T-D-Rabbit/ProjectCarRocketBoy/docs/pcb_mcu_zone.png

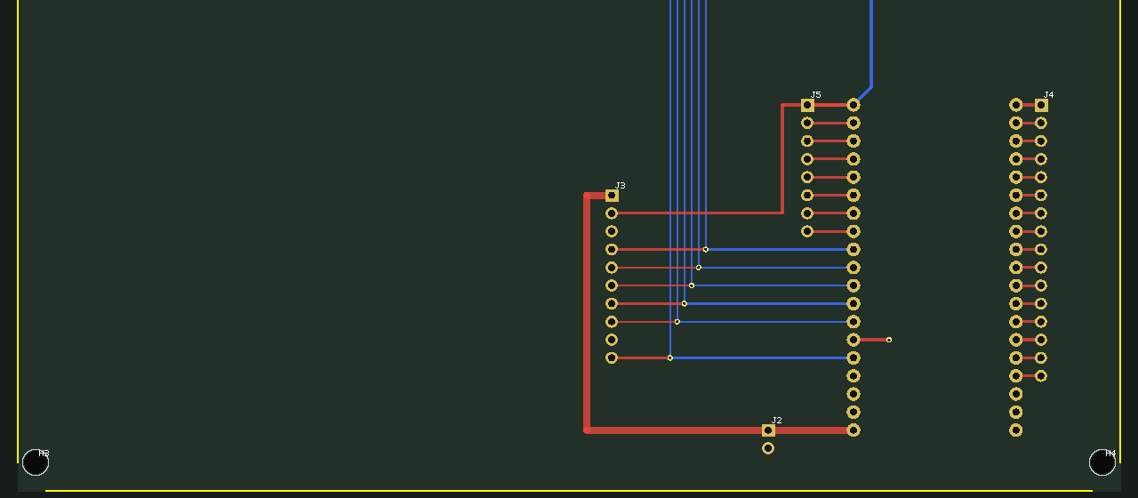
docs/pcb_mcu_zone.png
