T-D-Rabbit/ProjectCarRocketBoy/docs/pcb_power_channel.png

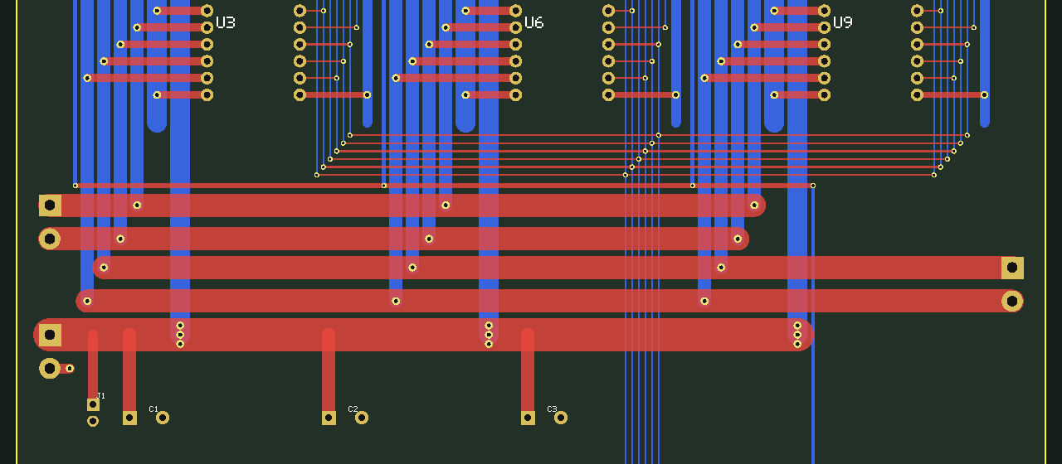
docs/pcb_power_channel.png
