T-D-Rabbit/ProjectCarRocketBoy/model3d/out/preview_front.png

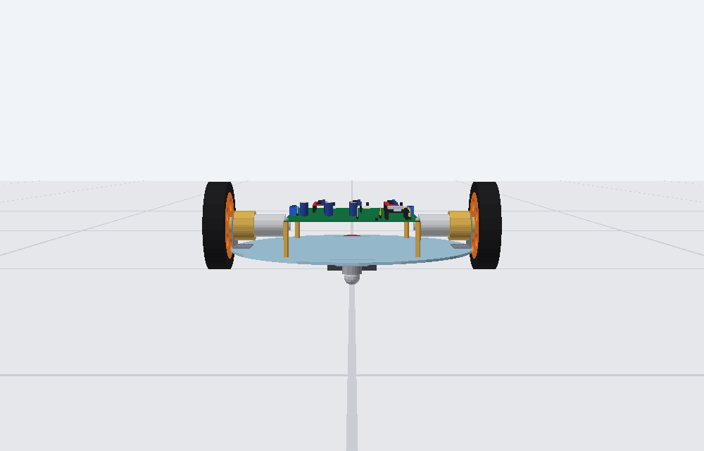
model3d/out/preview_front.png
