T-D-Rabbit/ProjectCarRocketBoy/model3d/out/preview_side.png

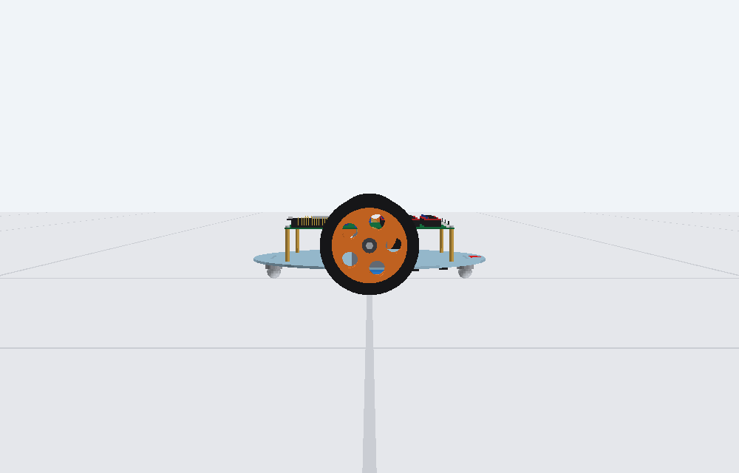
model3d/out/preview_side.png
