T-D-Rabbit/ProjectCarRocketBoy/model3d/out/preview_top.png

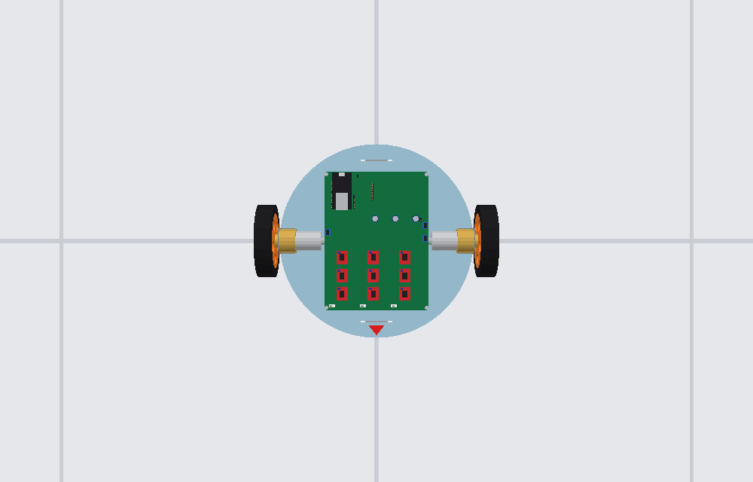
model3d/out/preview_top.png
