T-D-Rabbit/ProjectCarRocketBoy/model3d/out/preview_under.png

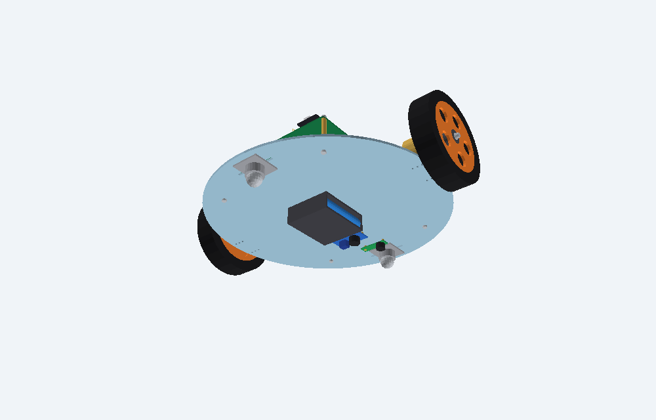
model3d/out/preview_under.png
