T-D-Rabbit/ProjectCarRocketBoy/model3d/out/rocketboy_assembly.stl

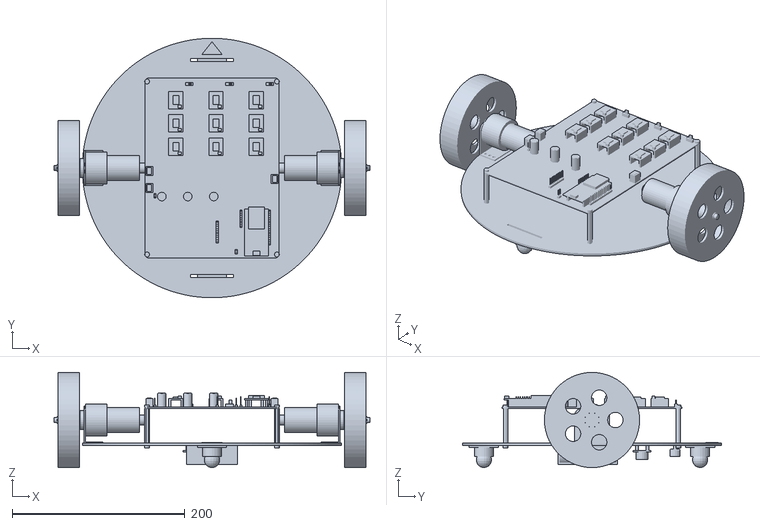
[picture p10: CAD file, 2026-10-31]
model3d/out/rocketboy_assembly.stl
365.4 x 300.0 x 110.0
