T-D-Rabbit/ProjectCarRocketBoy/Chassis file.step

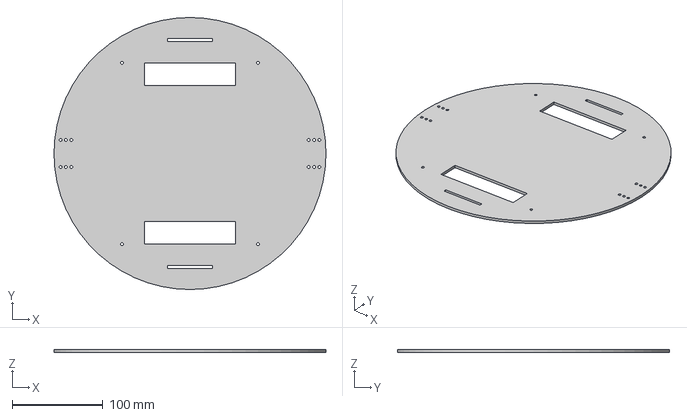
[picture p11: CAD file, 2026-10-31]
Chassis file.step
300.0 x 300.0 x 3.00 mm
