T-D-Rabbit/ProjectCarRocketBoy/model3d/out/rocketboy_body.stl

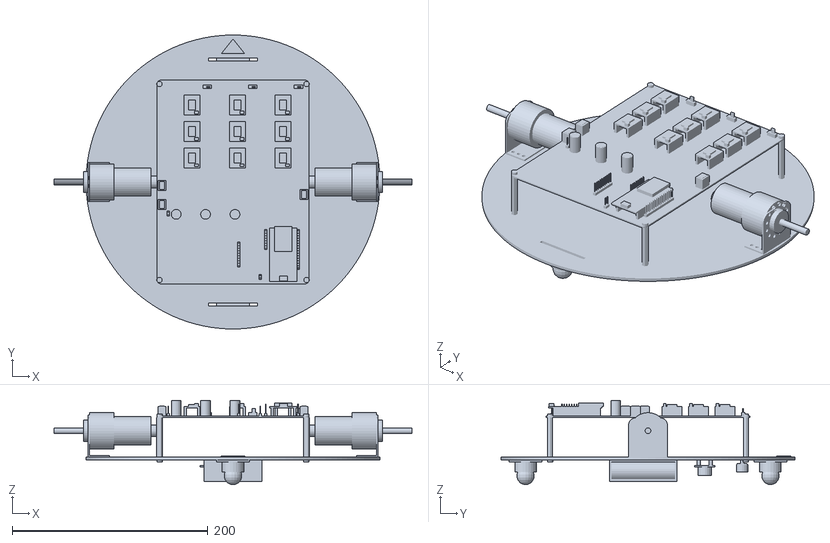
[picture p12: CAD file, 2026-10-31]
model3d/out/rocketboy_body.stl
365.4 x 300.0 x 86.1
