T-D-Rabbit/ProjectCarRocketBoy/model3d/out/rocketboy_wheel_left.stl

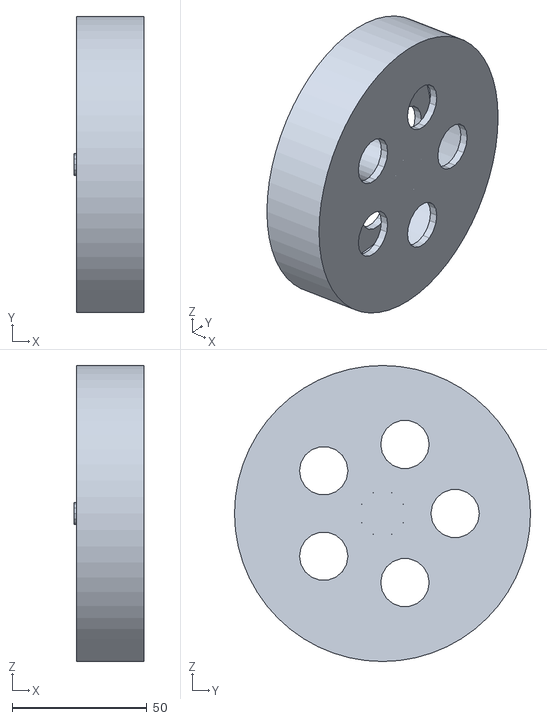
[picture p13: CAD file, 2026-10-31]
model3d/out/rocketboy_wheel_left.stl
26.0 x 110.0 x 110.0
