T-D-Rabbit/ProjectCarRocketBoy/(list of files, cad)

Other CAD files:
model3d/out/rocketboy.obj
model3d/out/rocketboy_wheel_right.stl
