T-D-Rabbit/ProjectCarRocketBoy/simulation/results/S1_launch_1group.csv

t | x | y | th | v | wz | il | ir | vbat | soc | ibat
0.0005 | 0 | 0 | 0 | 0 | 0 | 6.83726 | 6.88587 | 10.8786 | 0.899999 | 14.0731
0.01 | 0.000239984 | 6.3263e-10 | 4.48349e-06 | 0.0525382 | 0.000780485 | 5.82054 | 5.85912 | 11.085 | 0.899988 | 12.0297
0.02 | 0.00110173 | 9.05709e-09 | 1.38014e-05 | 0.116773 | 0.0010174 | 5.54294 | 5.57682 | 11.1415 | 0.899976 | 11.4698
0.03 | 0.0026089 | 3.87064e-08 | 2.4355e-05 | 0.181445 | 0.00107776 | 5.28424 | 5.31386 | 11.1942 | 0.899965 | 10.9481
0.04 | 0.00476314 | 1.04044e-07 | 3.52446e-05 | 0.246171 | 0.00109606 | 5.04268 | 5.06847 | 11.2433 | 0.899954 | 10.4612
0.05 | 0.00756472 | 2.19544e-07 | 4.62476e-05 | 0.310908 | 0.00110336 | 4.81708 | 4.83943 | 11.2892 | 0.899944 | 10.0065
0.06 | 0.0110137 | 3.9966e-07 | 5.73096e-05 | 0.375647 | 0.00110895 | 4.60638 | 4.62563 | 11.3321 | 0.899935 | 9.58201
0.07 | 0.01511 | 6.58933e-07 | 6.84455e-05 | 0.440385 | 0.00111919 | 4.40959 | 4.42607 | 11.3721 | 0.899925 | 9.18566
0.08 | 0.0198537 | 1.01229e-06 | 7.97607e-05 | 0.505116 | 0.00114764 | 4.22577 | 4.23979 | 11.4094 | 0.899916 | 8.81556
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
