T-D-Rabbit/ProjectCarRocketBoy/simulation/results/S5_route_30hz.csv

t | x | y | th | phil | phir | v | wz | il | ir | vbat | ul | ur | seg
0.005 | 9.32264e-07 | 1.76697e-14 | 3.16603e-08 | 4.45184e-05 | 4.48415e-05 | 0.000436205 | 1.37026e-05 | 0.0993634 | 0.10005 | 12.2445 | 0.015 | 0.015 | side 1
0.035 | 0.000173748 | 4.05817e-10 | 4.48549e-06 | 0.00397152 | 0.00400148 | 0.0132362 | 0.000332022 | 0.653834 | 0.658066 | 12.1321 | 0.105 | 0.105 | side 1
0.07 | 0.0011294 | 1.66401e-08 | 2.94938e-05 | 0.0232924 | 0.0234808 | 0.0440165 | 0.00120297 | 1.23206 | 1.23934 | 12.015 | 0.21 | 0.21 | side 1
0.1 | 0.00307709 | 1.28119e-07 | 8.42698e-05 | 0.0613378 | 0.0618679 | 0.0881543 | 0.00248894 | 1.65462 | 1.66333 | 11.9295 | 0.3 | 0.3 | side 1
0.135 | 0.00740478 | 7.5533e-07 | 0.000202441 | 0.144259 | 0.145518 | 0.161796 | 0.00426297 | 2.06138 | 2.07083 | 11.8472 | 0.405 | 0.405 | side 1
0.17 | 0.0146786 | 2.90995e-06 | 0.000384432 | 0.28184 | 0.284215 | 0.255525 | 0.00611258 | 2.39132 | 2.40089 | 11.7805 | 0.51 | 0.51 | side 1
0.2 | 0.023742 | 7.3628e-06 | 0.000591821 | 0.451951 | 0.455593 | 0.348972 | 0.00768019 | 2.62454 | 2.63387 | 11.7334 | 0.6 | 0.6 | side 1
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
