T-D-Rabbit/ProjectCarRocketBoy/simulation/results/S1_launch.png

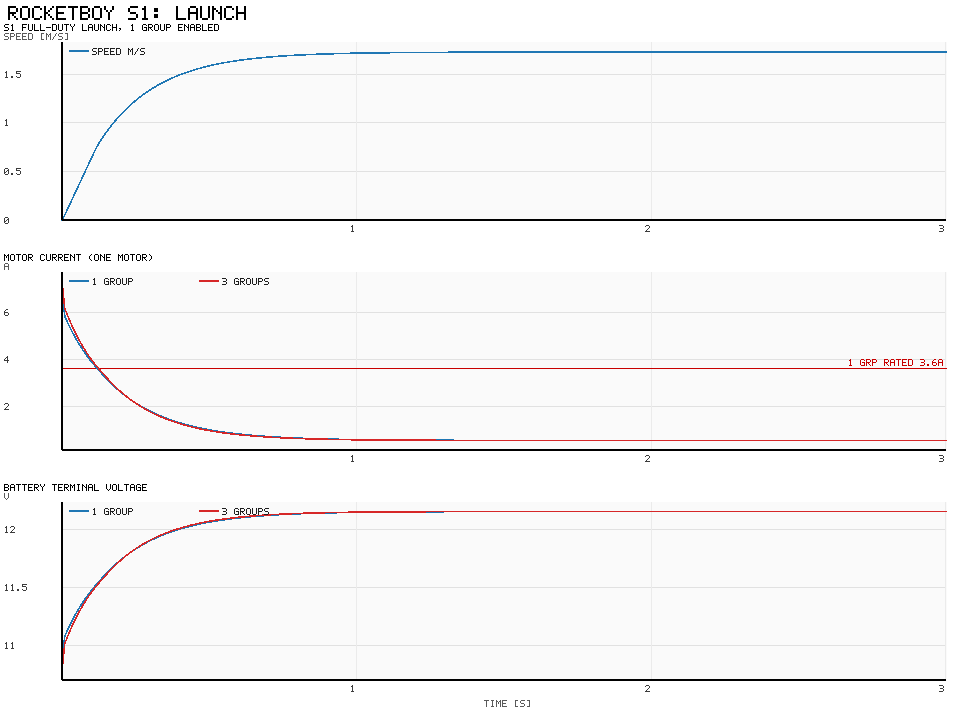
simulation/results/S1_launch.png
