T-D-Rabbit/ProjectCarRocketBoy/simulation/results/S5_route.png

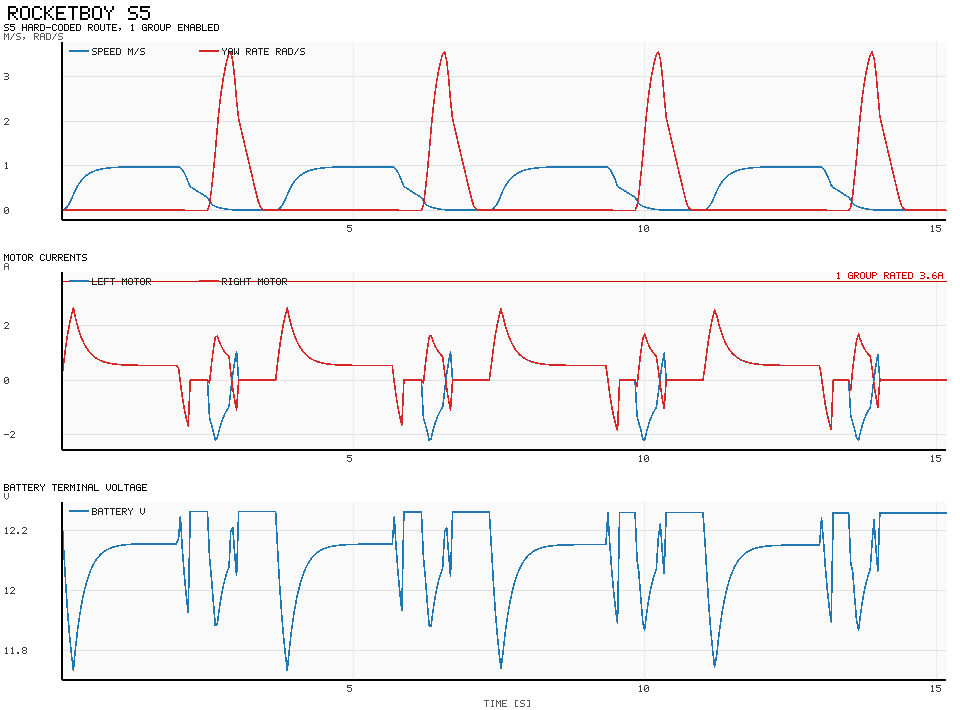
simulation/results/S5_route.png
