T-D-Rabbit/ProjectCarRocketBoy/simulation/results/S5_route_topview.png

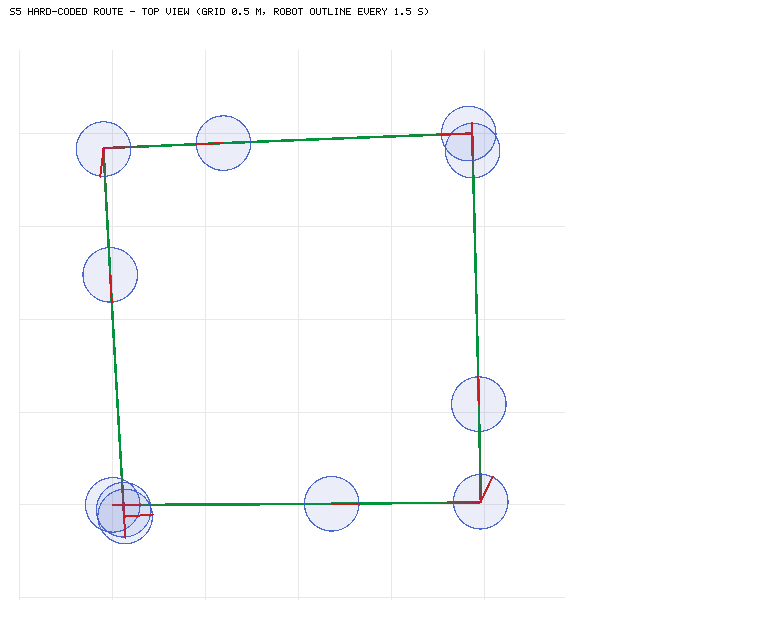
simulation/results/S5_route_topview.png
