T-D-Rabbit/ProjectCarRocketBoy/Johnson Motor.pdf

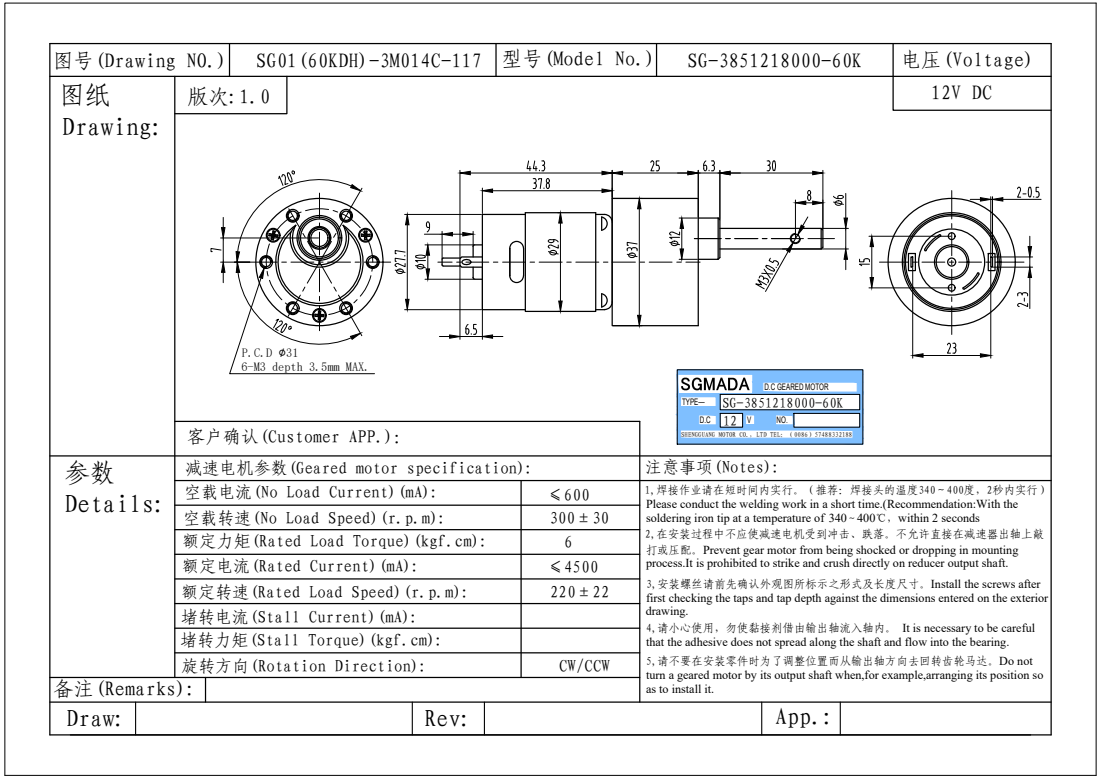
[picture p17: page 1]
图号(Drawing NO.); 型号(Model No.); 电压(Voltage) Draw:; Rev:; App.: 版次:1.0 客户确认(Customer APP.)：; 12V DC CW/CCW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

额定转速(Rated Load Speed)(r.p.m): 减速电机参数(Geared motor specification): Details: 空载转速(No Load Speed)(r.p.m):

空载电流(No Load Current)(mA): 参数

额定力矩(Rated Load Torque)(kgf.cm):
额定电流(Rated Current)(mA):

堵转电流(Stall Current)(mA):
堵转力矩(Stall Torque)(kgf.cm):
旋转方向(Rotation Direction):

备注(Remarks):
