T-D-Rabbit/ProjectCarRocketBoy/L Clamp.pdf

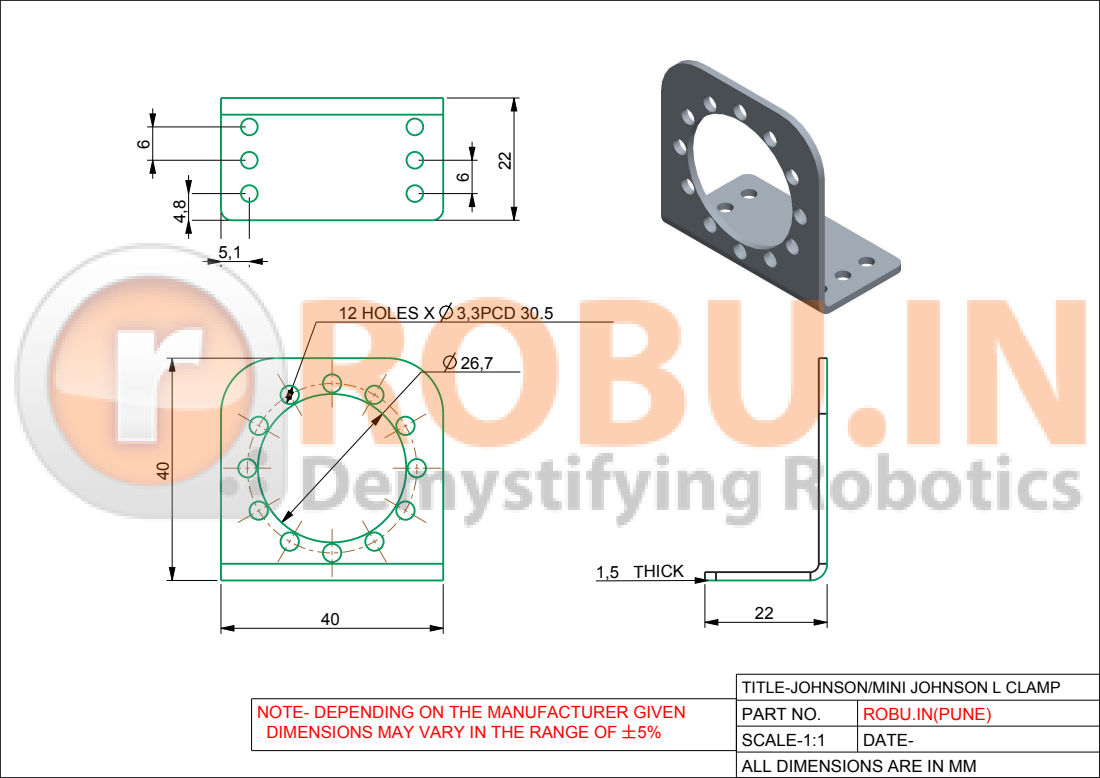
[picture p18: page 1]
1,5 THICK; 12 HOLES X 3,3PCD 30.5; DIMENSIONS MAY VARY IN THE RANGE OF

TITLE-JOHNSON/MINI JOHNSON L CLAMP

NOTE- DEPENDING ON THE MANUFACTURER GIVEN | PART NO. | ROBU.IN(PUNE)

SCALE-1:1 | DATE-

ALL DIMENSIONS ARE IN MM
