T-D-Rabbit/ProjectCarRocketBoy/RocketBoy/RocketBoy.kicad_pcb

## KiCad design RocketBoy/RocketBoy.kicad_pcb (2026-10-31)

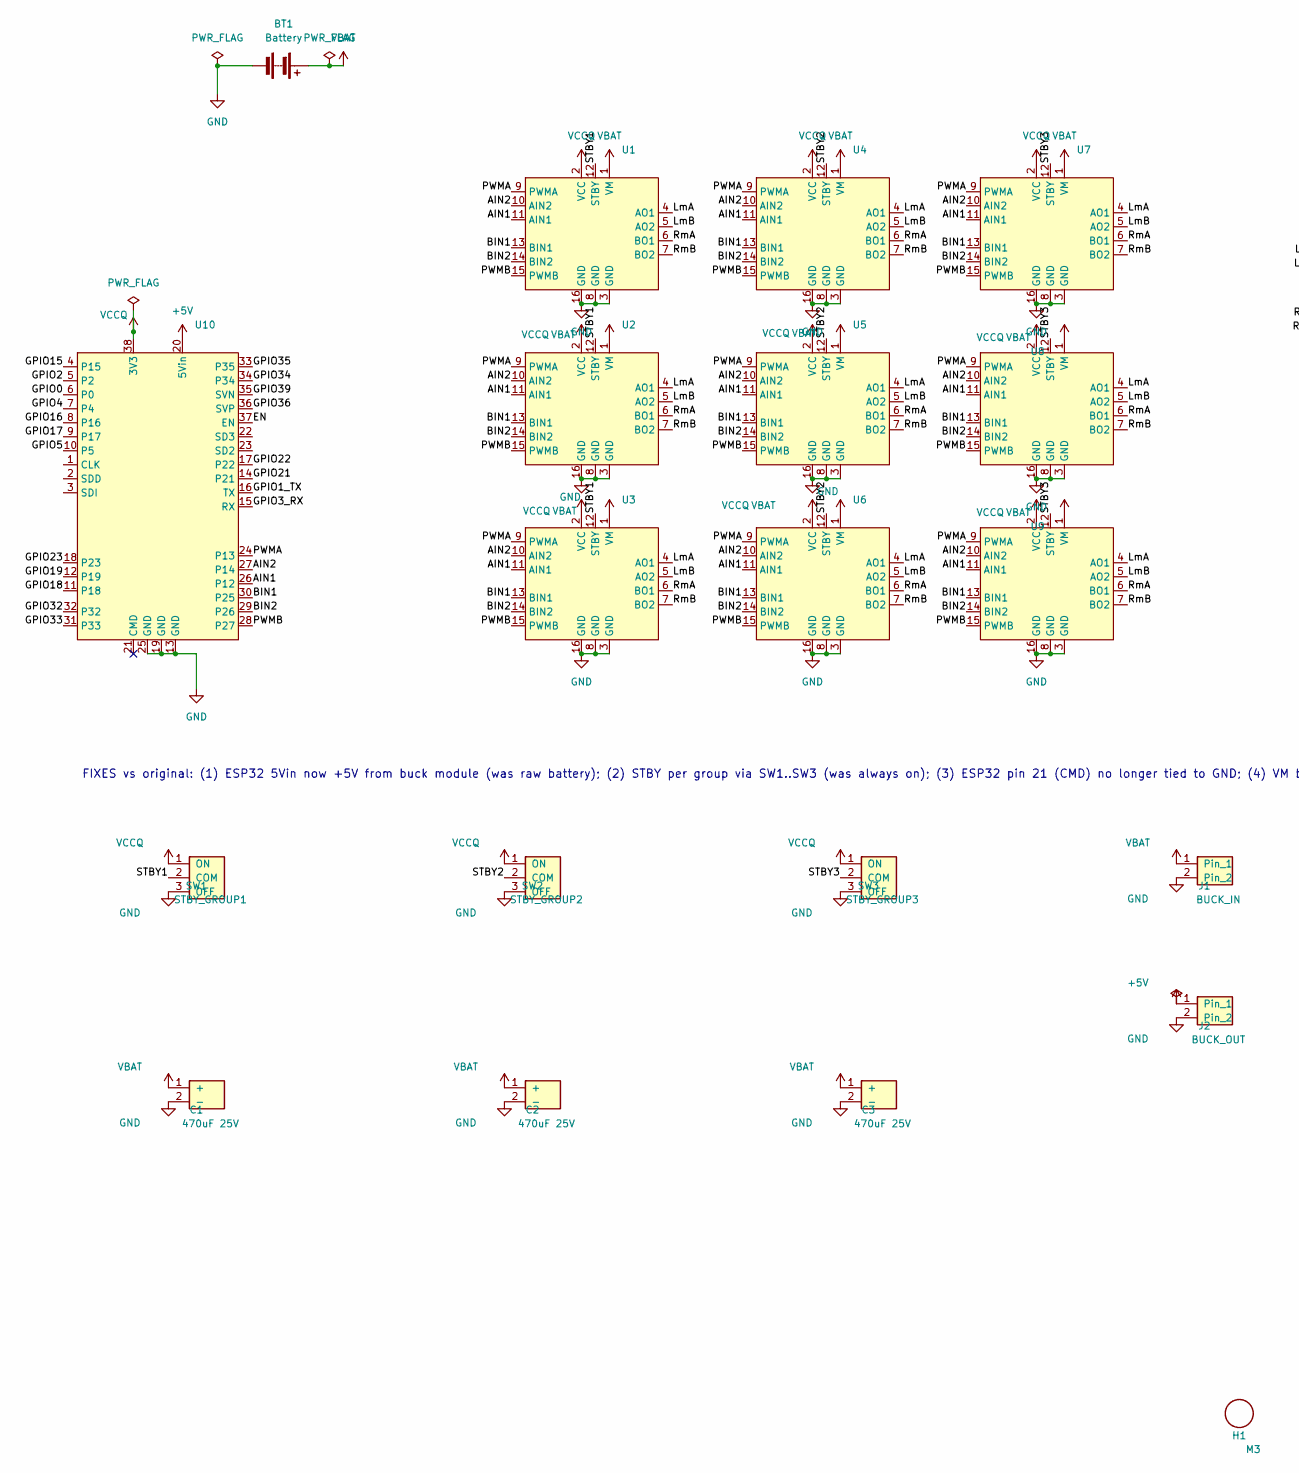
[picture p19: schematic RocketBoy.kicad_sch, part in row 1, column 1]

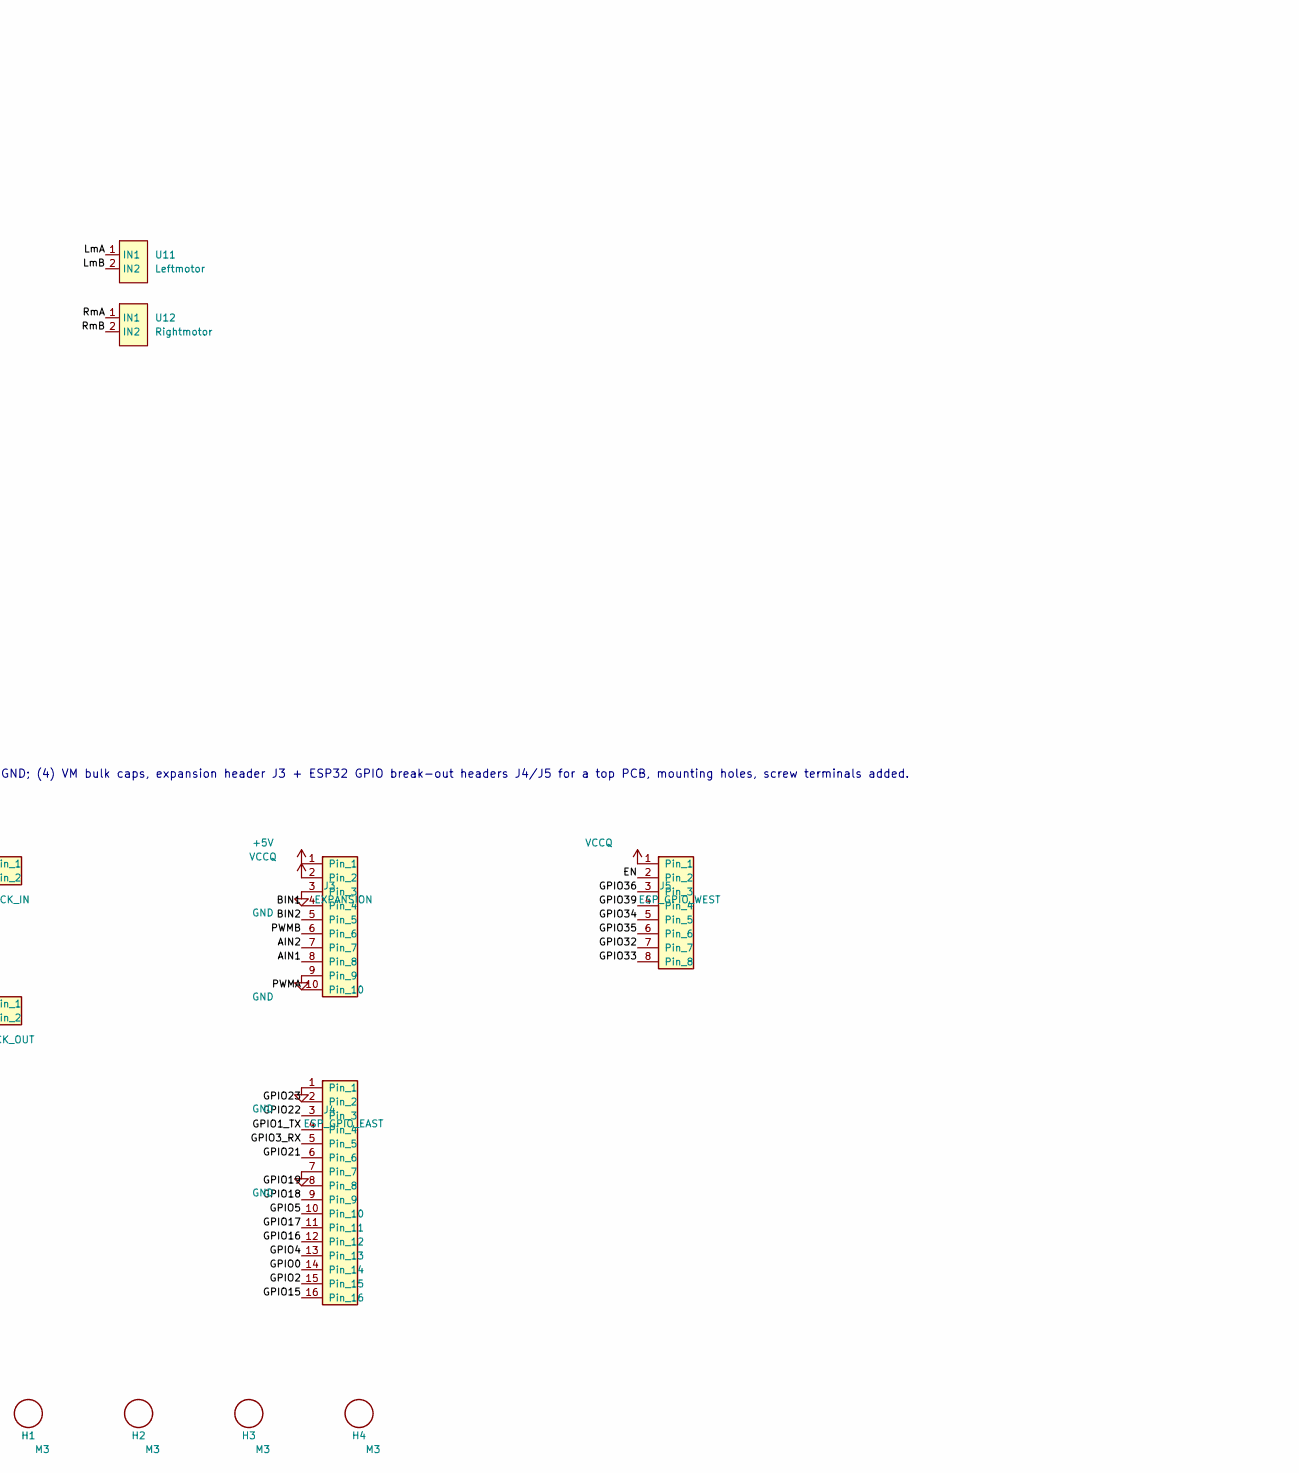
[picture p20: schematic RocketBoy.kicad_sch, part in row 1, column 2]

Parts:
BT1: Battery; TerminalBlock_5.08mm_2P_Vertical
C1, C2, C3: 470uF 25V; CP_Radial_D10.0mm_P5.00mm
H1, H2, H3, H4: M3; MountingHole_3.2mm_M3
J1: BUCK_IN; PinHeader_1x02_P2.54mm_Vertical
J2: BUCK_OUT; PinHeader_1x02_P2.54mm_Vertical
J3: EXPANSION; PinHeader_1x10_P2.54mm_Vertical
J4: ESP_GPIO_EAST; PinHeader_1x16_P2.54mm_Vertical
J5: ESP_GPIO_WEST; PinHeader_1x08_P2.54mm_Vertical
SW1: STBY_GROUP1; SPDT_Slide_1x03_P2.54mm
SW2: STBY_GROUP2; SPDT_Slide_1x03_P2.54mm
SW3: STBY_GROUP3; SPDT_Slide_1x03_P2.54mm
U1, U2, U3, U4, U5, U6, U7, U8, U9: TB6612FND_Motor_Driver
U10: ESP32Wroom
U11: Leftmotor; TerminalBlock_5.08mm_2P_Vertical
U12: Rightmotor; TerminalBlock_5.08mm_2P_Vertical

Connections:
+5V: J2.1, J3.1 (5V), U10.20 (5Vin)
/AIN1: J3.8 (AIN1), U1.11 (AIN1), U2.11 (AIN1), U3.11 (AIN1), U4.11 (AIN1), U5.11 (AIN1), U6.11 (AIN1), U7.11 (AIN1), U8.11 (AIN1), U9.11 (AIN1), U10.26 (P12)
/AIN2: J3.7 (AIN2), U1.10 (AIN2), U2.10 (AIN2), U3.10 (AIN2), U4.10 (AIN2), U5.10 (AIN2), U6.10 (AIN2), U7.10 (AIN2), U8.10 (AIN2), U9.10 (AIN2), U10.27 (P14)
/BIN1: J3.4 (BIN1), U1.13 (BIN1), U2.13 (BIN1), U3.13 (BIN1), U4.13 (BIN1), U5.13 (BIN1), U6.13 (BIN1), U7.13 (BIN1), U8.13 (BIN1), U9.13 (BIN1), U10.30 (P25)
/BIN2: J3.5 (BIN2), U1.14 (BIN2), U2.14 (BIN2), U3.14 (BIN2), U4.14 (BIN2), U5.14 (BIN2), U6.14 (BIN2), U7.14 (BIN2), U8.14 (BIN2), U9.14 (BIN2), U10.29 (P26)
/EN: J5.2 (EN), U10.37 (EN)
/GPIO0: J4.14 (GPIO0), U10.6 (P0)
/GPIO1_TX: J4.4 (TX0_GPIO1), U10.16 (TX)
/GPIO2: J4.15 (GPIO2), U10.5 (P2)
/GPIO3_RX: J4.5 (RX0_GPIO3), U10.15 (RX)
/GPIO4: J4.13 (GPIO4), U10.7 (P4)
/GPIO5: J4.10 (GPIO5), U10.10 (P5)
/GPIO15: J4.16 (GPIO15), U10.4 (P15)
/GPIO16: J4.12 (GPIO16), U10.8 (P16)
/GPIO17: J4.11 (GPIO17), U10.9 (P17)
/GPIO18: J4.9 (GPIO18), U10.11 (P18)
/GPIO19: J4.8 (GPIO19), U10.12 (P19)
/GPIO21: J4.6 (GPIO21), U10.14 (P21)
/GPIO22: J4.3 (GPIO22), U10.17 (P22)
/GPIO23: J4.2 (GPIO23), U10.18 (P23)
/GPIO32: J5.7 (GPIO32), U10.32
/GPIO33: J5.8 (GPIO33), U10.31 (P33)
/GPIO34: J5.5 (GPIO34), U10.34
/GPIO35: J5.6 (GPIO35), U10.33 (P35)
/GPIO36: J5.3 (GPIO36_SVP), U10.36 (SVP)
/GPIO39: J5.4 (GPIO39_SVN), U10.35 (SVN)
/LmA: U1.4 (AO1), U2.4 (AO1), U3.4 (AO1), U4.4 (AO1), U5.4 (AO1), U6.4 (AO1), U7.4 (AO1), U8.4 (AO1), U9.4 (AO1), U11.1 (IN1)
/LmB: U1.5 (AO2), U2.5 (AO2), U3.5 (AO2), U4.5 (AO2), U5.5 (AO2), U6.5 (AO2), U7.5 (AO2), U8.5 (AO2), U9.5 (AO2), U11.2 (IN2)
/PWMA: J3.10 (PWMA), U1.9 (PWMA), U2.9 (PWMA), U3.9 (PWMA), U4.9 (PWMA), U5.9 (PWMA), U6.9 (PWMA), U7.9 (PWMA), U8.9 (PWMA), U9.9 (PWMA), U10.24 (P13)
/PWMB: J3.6 (PWMB), U1.15 (PWMB), U2.15 (PWMB), U3.15 (PWMB), U4.15 (PWMB), U5.15 (PWMB), U6.15 (PWMB), U7.15 (PWMB), U8.15 (PWMB), U9.15 (PWMB), U10.28 (P27)
/RmA: U1.6 (BO1), U2.6 (BO1), U3.6 (BO1), U4.6 (BO1), U5.6 (BO1), U6.6 (BO1), U7.6 (BO1), U8.6 (BO1), U9.6 (BO1), U12.1 (IN1)
/RmB: U1.7 (BO2), U2.7 (BO2), U3.7 (BO2), U4.7 (BO2), U5.7 (BO2), U6.7 (BO2), U7.7 (BO2), U8.7 (BO2), U9.7 (BO2), U12.2 (IN2)
/STBY1: SW1.2 (COM), U1.12 (STBY), U2.12 (STBY), U3.12 (STBY)
/STBY2: SW2.2 (COM), U4.12 (STBY), U5.12 (STBY), U6.12 (STBY)
/STBY3: SW3.2 (COM), U7.12 (STBY), U8.12 (STBY), U9.12 (STBY)
GND: BT1.2 (-), C1.2 (-), C2.2 (-), C3.2 (-), J1.2, J2.2, J3.3 (GND), J3.9 (GND), J4.1 (GND), J4.7 (GND), SW1.3 (OFF), SW2.3 (OFF), SW3.3 (OFF), U1.3 (GND), U1.8 (GND), U1.16 (GND), U2.3 (GND), U2.8 (GND), U2.16 (GND), U3.3 (GND), U3.8 (GND), U3.16 (GND), U4.3 (GND), U4.8 (GND), U4.16 (GND), U5.3 (GND), U5.8 (GND), U5.16 (GND), U6.3 (GND), U6.8 (GND), U6.16 (GND), U7.3 (GND), U7.8 (GND), U7.16 (GND), U8.3 (GND), U8.8 (GND), U8.16 (GND), U9.3 (GND), U9.8 (GND), U9.16 (GND), U10.13 (GND), U10.19 (GND), U10.25 (GND)
VBAT: BT1.1 (+), C1.1 (+), C2.1 (+), C3.1 (+), J1.1, U1.1 (VM), U2.1 (VM), U3.1 (VM), U4.1 (VM), U5.1 (VM), U6.1 (VM), U7.1 (VM), U8.1 (VM), U9.1 (VM)
VCCQ: J3.2 (3V3), J5.1 (3V3), SW1.1 (ON), SW2.1 (ON), SW3.1 (ON), U1.2 (VCC), U2.2 (VCC), U3.2 (VCC), U4.2 (VCC), U5.2 (VCC), U6.2 (VCC), U7.2 (VCC), U8.2 (VCC), U9.2 (VCC), U10.38 (3V3)

Notes on the sheet:
FIXES vs original: (1) ESP32 5Vin now +5V from buck module (was raw battery); (2) STBY per group via SW1..SW3 (was always on); (3) ESP32 pin 21 (CMD) no longer tied to GND; (4) VM bulk caps, expansion header J3 + ESP32 GPIO break-out headers J4/J5 for a top PCB, mounting holes, screw terminals adde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

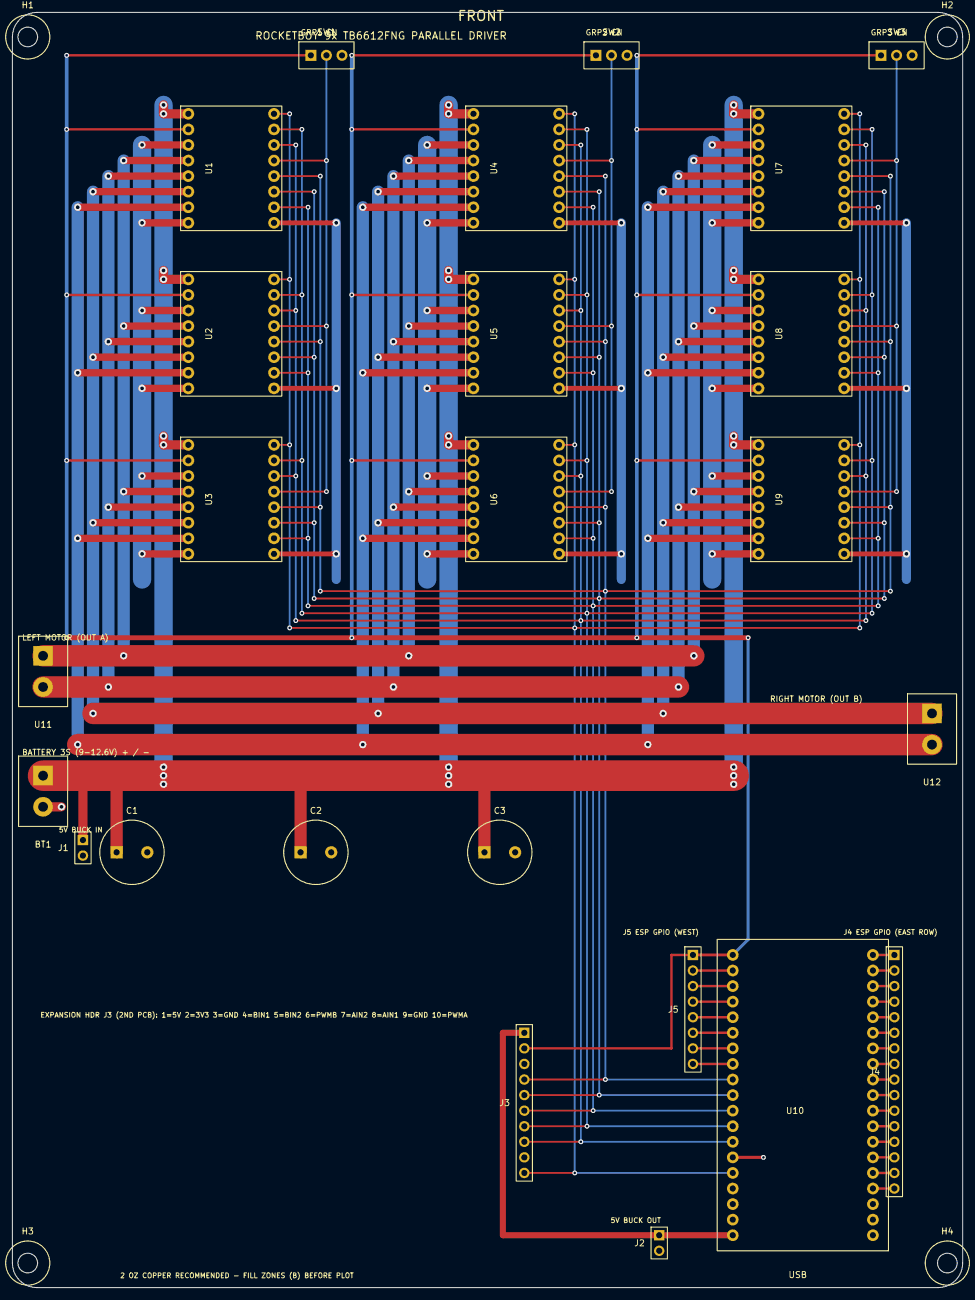
[picture p21: board RocketBoy.kicad_pcb from above]

Board: 2 copper layers, 155.0 x 208.0 mm, 28 parts (0 on the bottom side), 38 nets.
