T-D-Rabbit/ProjectCarRocketBoy/(commit log)

2026-10-31 Complete RocketBoy PCB, fix schematic errors, add simulation
    - schematic: 5V rail for ESP32 (was raw battery), per-group STBY enable switches,
    ESP32 pad 21 (CMD) no longer grounded, bulk caps, buck headers, IR array header, mounting holes
    - PCB: 158x208 mm outline on the chassis hole pattern, fully routed 2-layer board, GND pour,
    screw terminals, project footprint/symbol libraries
    - simulation: motor/battery/TB6612 bank/chassis model, launch, stall, hill, spin, line-follow, PCB copper checks
    - tools: generators and checkers (clearance, connectivity, pour flood-fill, sch-vs-pcb netlist)
    [RocketBoy.kicad_pcb, RocketBoy.kicad_sch, S1_launch_1group.csv, S5_line_follow_1group.csv]
2026-10-31 Add 3D model + route animation, hard-coded route sim/firmware, expansion header; fix clamp mounting assumption
    - model3d: parametric robot model (STL/OBJ, interactive HTML viewer, GIF, renders) built from STEP/PDF dimensions and PCB positions
    - simulation: IR line-follow scenario replaced by hard-coded open-loop route (calibrated spins, slew-limited duty); wheel 110 mm; clamps on top face
    - firmware: ESP32 sketch generated from the same route
    - PCB/schematic: IR header replaced by 1x10 expansion header J3 (5V, 3V3, GND, 6 control lines); board narrowed to 155 mm to clear motor rear bosses
    - README: corrects my earlier under-chassis clamp assumption
    [RocketBoy.kicad_pcb, RocketBoy.kicad_sch, S1_launch_1group.csv, S5_line_follow_1group.csv, S5_route_30hz.csv, rocketboy.obj, rocketboy_assembly.stl, rocketboy_body.stl]
2026-10-31 Interactive single-file simulator, ESP32 GPIO break-out headers J4/J5
    - RocketBoy_Simulator.html: double-click 3D simulator with keyboard/on-screen drive controls, SW1-3 enable switches,
    jam/stall test, soft-start toggle, hard-coded route, module-current grid and charts (JS port of rocketbot.py, bit-identical, tested)
    - PCB/schematic: J5 (west ESP32 row, 8 pins) and J4 (east row, 16 pins) break out every usable unused pin; J3 expansion header kept
    - 3D model shows the new headers; README rewritten as a run-first submission guide; stall wording corrected (free tyres slip first)
    [RocketBoy.kicad_pcb, RocketBoy.kicad_sch, rocketboy.obj, rocketboy_assembly.stl, rocketboy_body.stl]
2026-10-31 Use 7.5 A stall current: motor model refit (R=1.6 ohm), JS/Python parity kept, docs and specs updated, fuse 10 A
    [S1_launch_1group.csv, S5_route_30hz.csv]
